skot/apw-meister/doc/apw-meister-bom.csv

Reference | Value | Footprint | Manufacturer | MPN | JLCPCB Part # | DNP | Assembly note
C10 | 0.1uF | aditBoard:C_0402_1005Metric | Samsung Electro-Mechanics | CL05B104KB54PNC | C307331
C17 | 1uF | aditBoard:C_0402_1005Metric | Samsung Electro-Mechanics | CL05A105KA5NQNC | C52923
C18 | 1uF | aditBoard:C_0402_1005Metric | Samsung Electro-Mechanics | CL05A105KA5NQNC | C52923
C19 | 100nF | aditBoard:C_0402_1005Metric | Samsung Electro-Mechanics | CL05B104KB54PNC | C307331
J1 | USB4105-GF-A-120 | aditBoard:USB_C_Receptacle_GCT_USB4105-xx-A_16P_TopMnt_Horizontal | Global Connector Technology | USB4105-GF-A-120 | C5184243
J2 | APW12 PSU Comm | aditBoard:CONN-TH_6P-P2.00_PHD-2X3A | HCTL | HC-PHD-2*3A | C2845614
Q1 | DMG1012T-7 | aditBoard:SOT-523 | Diodes Incorporated | DMG1012T-7 | C20512
Q2 | DMG1012T-7 | aditBoard:SOT-523 | Diodes Incorporated | DMG1012T-7 | C20512
Q3 | DMG1012T-7 | aditBoard:SOT-523 | Diodes Incorporated | DMG1012T-7 | C20512
R2 | 0 | aditBoard:R_0402_1005Metric | UNI-ROYAL(Uniroyal Elec) | 0402WGF0000TCE | C17168 |  | USB series tuning position; fit 0 ohm for WCH reference circuit.
R3 | 0 | aditBoard:R_0402_1005Metric | UNI-ROYAL(Uniroyal Elec) | 0402WGF0000TCE | C17168 |  | USB series tuning position; fit 0 ohm for WCH reference circuit.
R4 | 5.1k | aditBoard:R_0402_1005Metric | UNI-ROYAL(Uniroyal Elec) | 0402WGF5101TCE | C25905
R5 | 5.1k | aditBoard:R_0402_1005Metric | UNI-ROYAL(Uniroyal Elec) | 0402WGF5101TCE | C25905
R6 | 4.7k | aditBoard:R_0402_1005Metric | UNI-ROYAL(Uniroyal Elec) | 0402WGF4701TCE | C25900 |  | BOOT pull-up to 3.3 V through optional SW2.
R7 | 49.9k | aditBoard:R_0402_1005Metric | YAGEO | RC0402FR-0749K9L | C137969
R9 | 330 | aditBoard:R_0402_1005Metric | UNI-ROYAL(Uniroyal Elec) | 0402WGF3300TCE | C25104
R10 | 4.7k | aditBoard:R_0402_1005Metric | UNI-ROYAL(Uniroyal Elec) | 0402WGF4701TCE | C25900 |  | FIT: MCU-side 4.7k pull-up; APW side uses PSU pull-ups.
R11 | 4.7k | aditBoard:R_0402_1005Metric | UNI-ROYAL(Uniroyal Elec) | 0402WGF4701TCE | C25900 |  | FIT: MCU-side 4.7k pull-up; APW side uses PSU pull-ups.
R12 | 1k | aditBoard:R_0402_1005Metric | YAGEO | RC0402FR-071KL | C106235
R13 | 10k | aditBoard:R_0402_1005Metric | UNI-ROYAL(Uniroyal Elec) | 0402WGF1002TCE | C25744
SW2 | B3U-1000P | aditBoard:SW_SPST_B3U-1000P | Omron Electronics | B3U-1000P | C231329 | DNP | DNP: optional bottom-side development button.
SW3 | B3U-1000P | aditBoard:SW_SPST_B3U-1000P | Omron Electronics | B3U-1000P | C231329 | DNP | DNP: optional bottom-side development button.
TP1 | APW12_PIN1 | aditBoard:TestPoint_Pad_D1.0mm |  |  |  |  | Bare PCB copper test pad; no purchased component or JLCPCB part number.
TP2 | APW12_PIN4 | aditBoard:TestPoint_Pad_D1.0mm |  |  |  |  | Bare PCB copper test pad; no purchased component or JLCPCB part number.
U1 | SK6812SIDE-A-RVS | aditBoard:LED-SMD_4P-L4.0-W1.6-L | OPSCO Optoelectronics | SK6812SIDE-A-RVS | C2890037
U3 | CH32X035F8U6 | aditBoard:VQFN-20-1EP_3x3mm_P0.4mm_EP1.7x1.7mm | WCH (Jiangsu Qin Heng) | CH32X035F8U6 | C42442062 |  | QFN20 3x3 mm; exposed ground pad is pad 21 in this library.
U4 | AP2112K-3.3TRG1 | aditBoard:SOT-25-5_L2.9-W1.6-P0.95-LS2.8-BL | Diodes Incorporated | AP2112K-3.3TRG1 | C51118
U5 | TPD6E05U06RVZR | aditBoard:Texas_R-PUSON-N14 | Texas Instruments | TPD6E05U06RVZR | C962978
U6 | TPD4E05U06DQAR | aditBoard:USON-10_2.5x1.0mm_P0.5mm | Texas Instruments | TPD4E05U06DQAR | C138714
