skot/apw-meister/3d/kicad/Texas_R-PUSON-N14.step

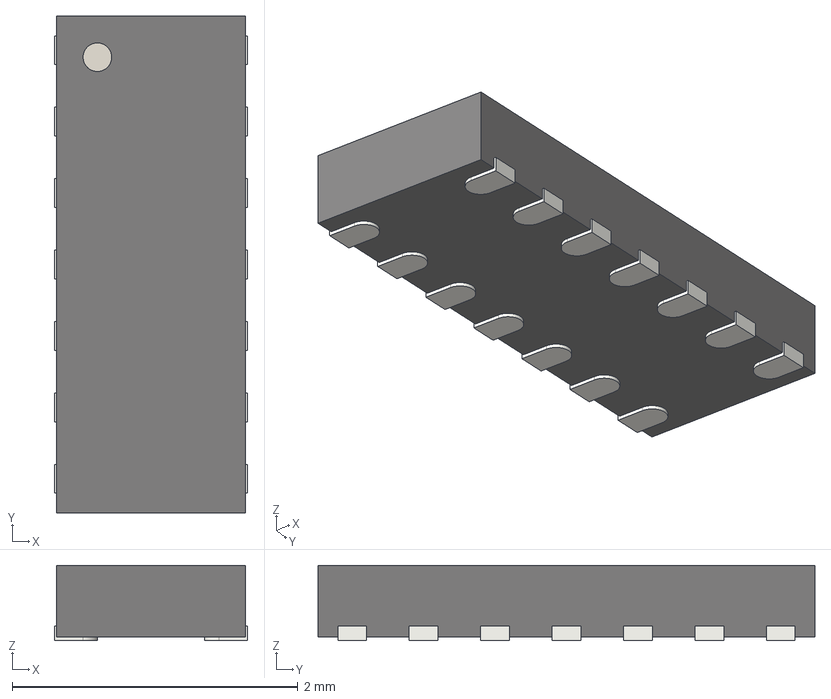
[picture p2: CAD file, 2026-10-26]
3d/kicad/Texas_R-PUSON-N14.step
1.35 x 3.48 x 0.525 mm
