skot/apw-meister/CAD/apw-meister.step

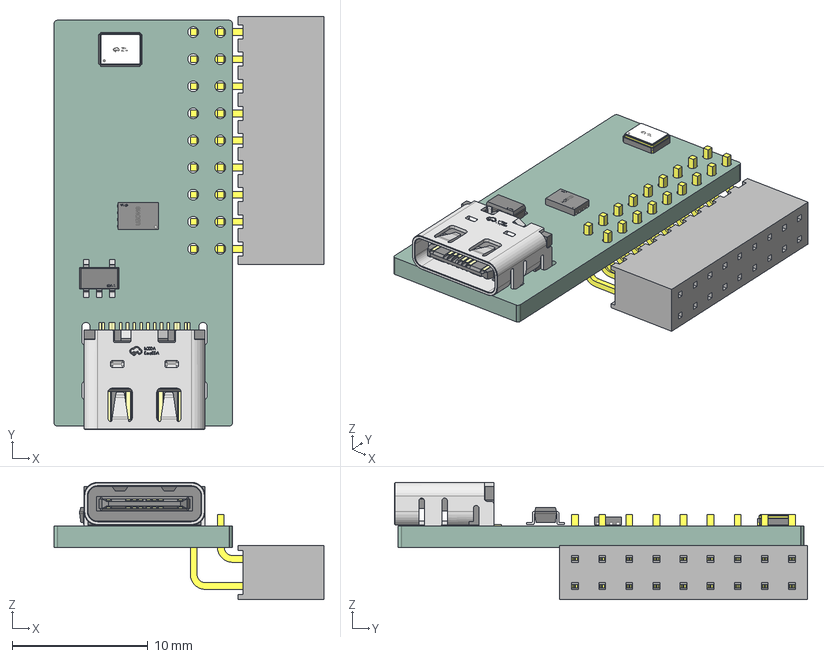
[picture p3: CAD file, 2026-10-22]
CAD/apw-meister.step
19.9 x 30.5 x 8.66 mm
SOT-25-5_L2.9-W1.6-P0.95-LS2.8-BL
USON-8_L3.0-W2.0-H0.6-P0.50
SQT-109-01-F-D-RA
OSC-SMD_4P-L3.2-W2.5-CJ13-320001210A20
USB-C-SMD_G-SWITCH_GT-USB-7010ASV
aditBoard_PCB
