skot/apw-meister/apw-meister.kicad_pcb

## KiCad design apw-meister.kicad_pcb (2026-10-27)

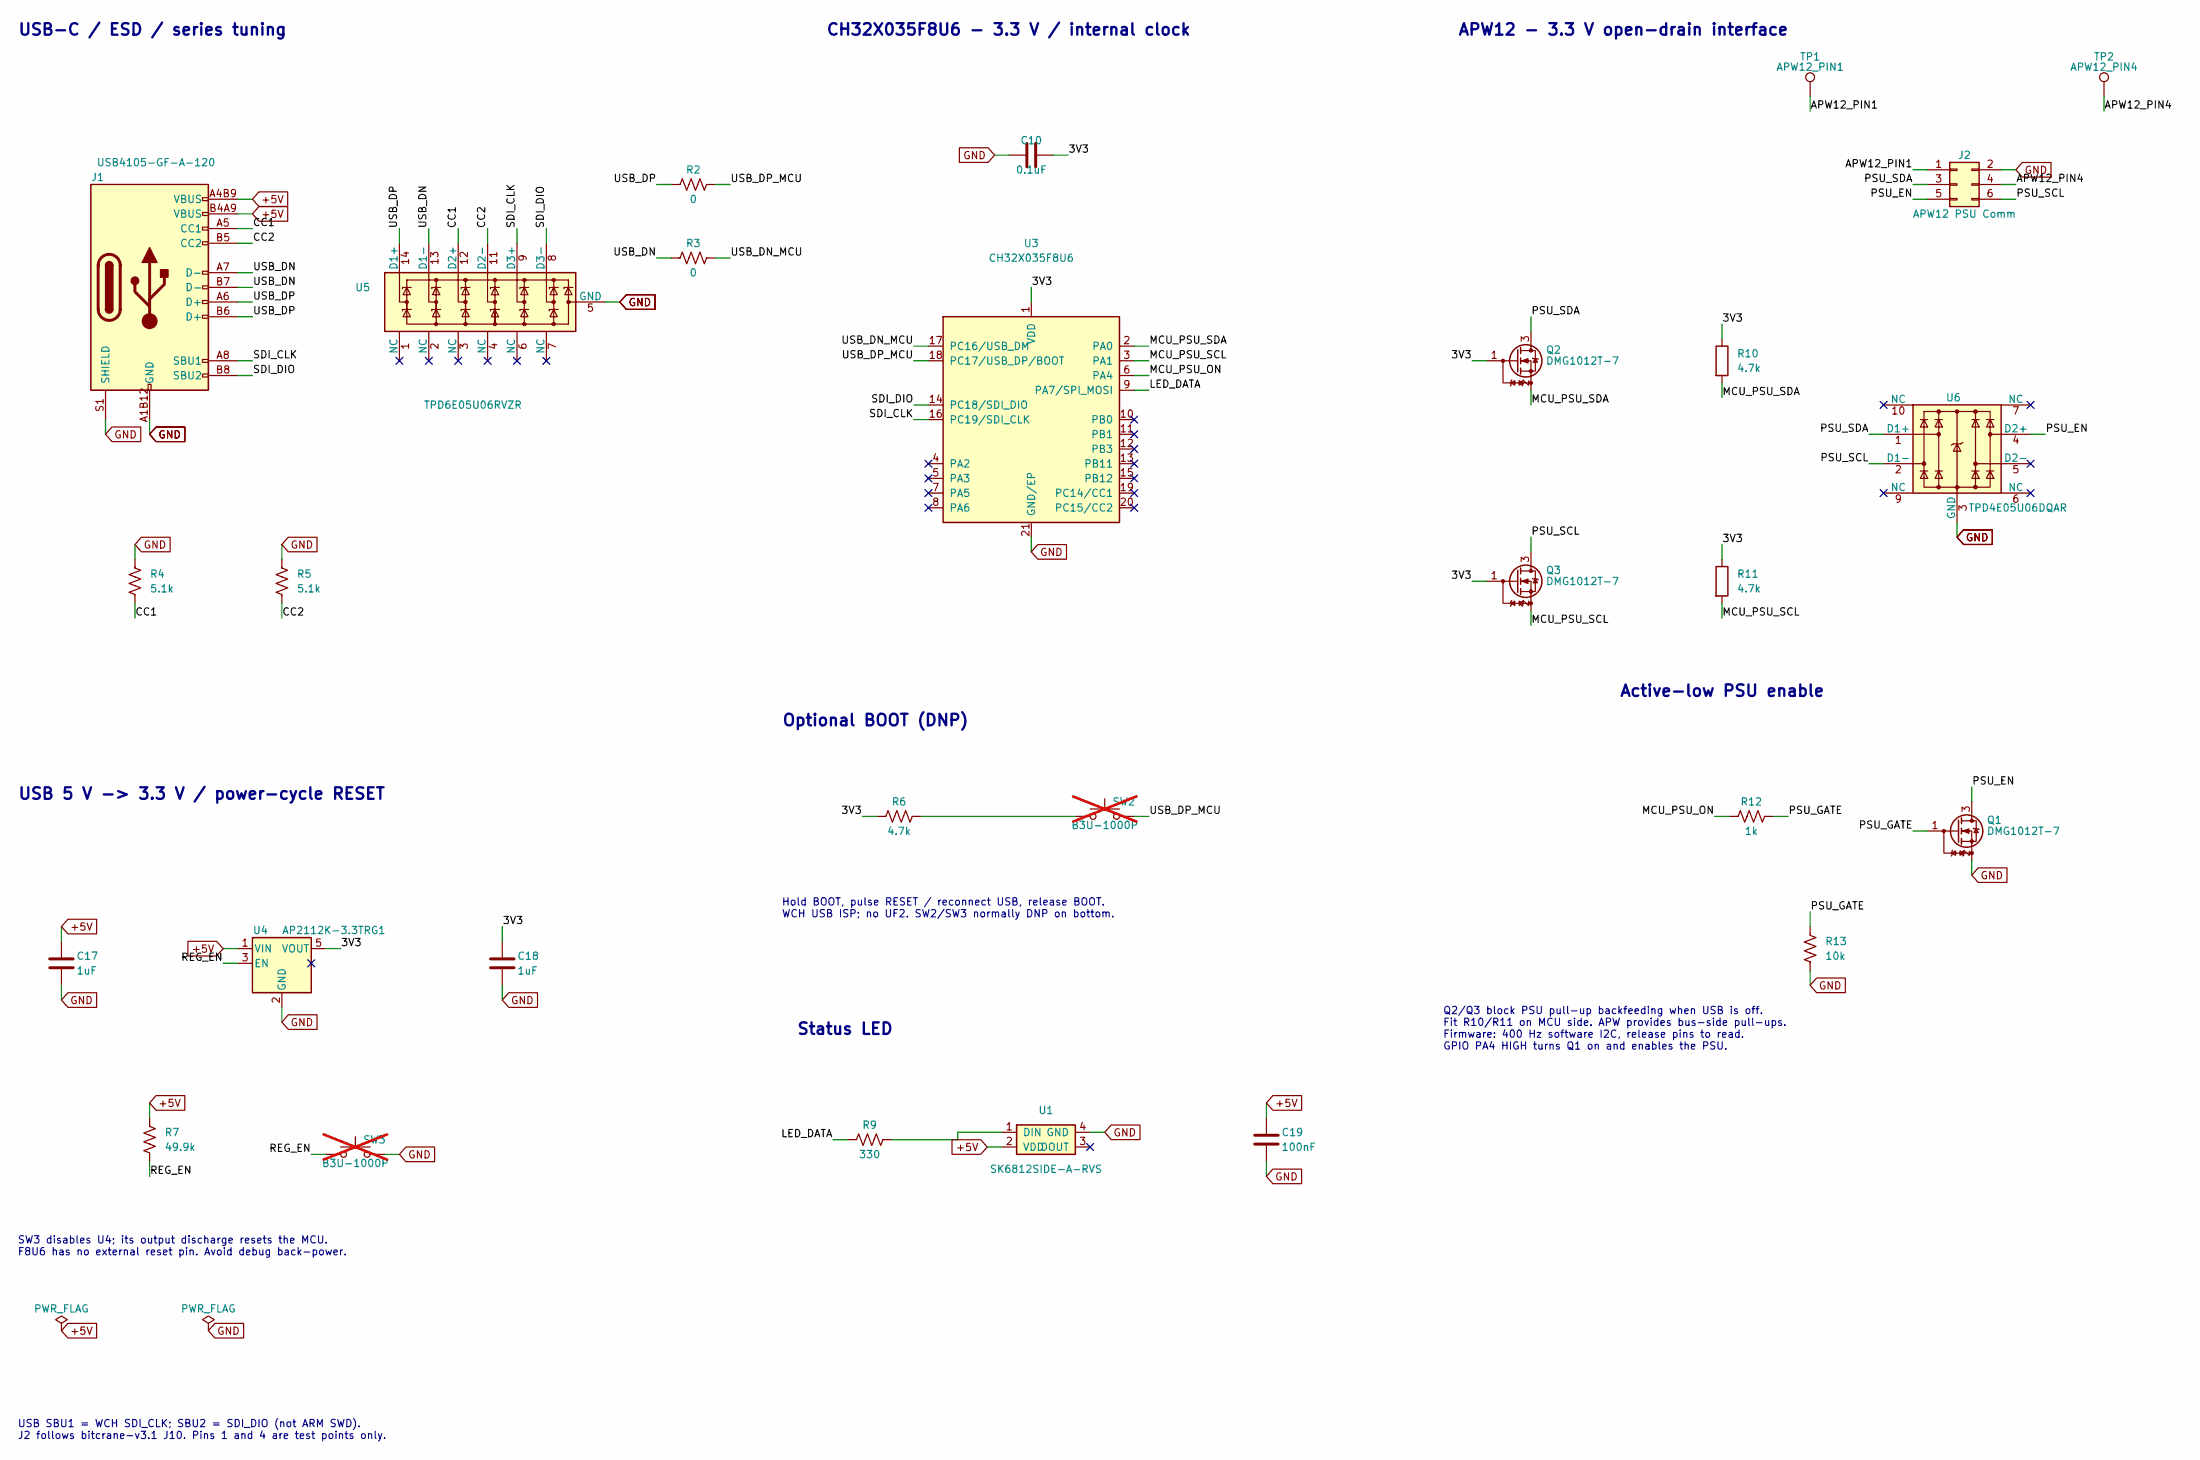
[picture p4: schematic apw-meister.kicad_sch, apw-meister - CH32X035F8U6]

Parts:
C10: 0.1uF; C_0402_1005Metric; Tolerance ±10%; Voltage 50V; MPN CL05B104KB54PNC; JLC Part Basic Part
C17, C18: 1uF; C_0402_1005Metric; Tolerance ±10%; Voltage 25V; MPN CL05A105KA5NQNC; JLC Part Basic Part
C19: 100nF; C_0402_1005Metric; Tolerance ±10%; Voltage 50V; MPN CL05B104KB54PNC; JLC Part Basic Part
J1: USB4105-GF-A-120; USB_C_Receptacle_GCT_USB4105-xx-A_16P_TopMnt_Horizontal; Voltage 48V; MPN USB4105-GF-A-120; JLC Part Extended Part
J2: APW12 PSU Comm; CONN-TH_6P-P2.00_PHD-2X3A; Voltage 250V; MPN HC-PHD-2*3A; JLC Part Extended Part
Q1, Q2, Q3: DMG1012T-7; SOT-523; MPN DMG1012T-7; JLC Part Extended Part
R2, R3: 0; R_0402_1005Metric; Tolerance ±1%; MPN 0402WGF0000TCE; JLC Part Basic Part
R4, R5: 5.1k; R_0402_1005Metric; Tolerance ±1%; MPN 0402WGF5101TCE; JLC Part Basic Part
R6, R10, R11: 4.7k; R_0402_1005Metric; Tolerance ±1%; MPN 0402WGF4701TCE; JLC Part Basic Part
R7: 49.9k; R_0402_1005Metric; Tolerance ±1%; MPN RC0402FR-0749K9L; JLC Part Extended Part
R9: 330; R_0402_1005Metric; Tolerance ±1%; MPN 0402WGF3300TCE; JLC Part Basic Part
R12: 1k; R_0402_1005Metric; Tolerance ±1%; MPN RC0402FR-071KL; JLC Part Extended Part
R13: 10k; R_0402_1005Metric; Tolerance ±1%; MPN 0402WGF1002TCE; JLC Part Basic Part
SW2, SW3: B3U-1000P; SW_SPST_B3U-1000P; Voltage 12V; MPN B3U-1000P; JLC Part Extended Part; not fitted
TP1: APW12_PIN1; TestPoint_Pad_D1.0mm
TP2: APW12_PIN4; TestPoint_Pad_D1.0mm
U1: SK6812SIDE-A-RVS; LED-SMD_4P-L4.0-W1.6-L; MPN SK6812SIDE-A-RVS; JLC Part Extended Part
U3: CH32X035F8U6; VQFN-20-1EP_3x3mm_P0.4mm_EP1.7x1.7mm; MPN CH32X035F8U6; JLC Part Extended Part
U4: AP2112K-3.3TRG1; SOT-25-5_L2.9-W1.6-P0.95-LS2.8-BL; MPN AP2112K-3.3TRG1; JLC Part Extended Part
U5: TPD6E05U06RVZR; Texas_R-PUSON-N14; MPN TPD6E05U06RVZR; JLC Part Extended Part
U6: TPD4E05U06DQAR; USON-10_2.5x1.0mm_P0.5mm; MPN TPD4E05U06DQAR; JLC Part Extended Part

Connections:
/3V3: C10.2, C18.1, Q2.1 (G), Q3.1 (G), R6.1, R10.1, R11.1, U3.1 (VDD), U4.5 (VOUT)
/APW12_PIN1: J2.1, TP1.1 (1_1)
/APW12_PIN4: J2.4, TP2.1 (1_1)
/CC1: J1.A5 (CC1), R4.2, U5.12 (D2+)
/CC2: J1.B5 (CC2), R5.2, U5.11 (D2-)
/LED_DATA: R9.1, U3.9 (PA7/SPI_MOSI)
/MCU_PSU_ON: R12.1, U3.6 (PA4)
/MCU_PSU_SCL: Q3.2 (S), R11.2, U3.3 (PA1)
/MCU_PSU_SDA: Q2.2 (S), R10.2, U3.2 (PA0)
/PSU_EN: J2.5, Q1.3 (D), U6.4 (D2+)
/PSU_GATE: Q1.1 (G), R12.2, R13.1
/PSU_SCL: J2.6, Q3.3 (D), U6.2 (D1-)
/PSU_SDA: J2.3, Q2.3 (D), U6.1 (D1+)
/REG_EN: R7.2, SW3.1, U4.3 (EN)
/SDI_CLK: J1.A8 (SBU1), U3.16 (PC19/SDI_CLK), U5.9 (D3+)
/SDI_DIO: J1.B8 (SBU2), U3.14 (PC18/SDI_DIO), U5.8 (D3-)
/USB_DN: J1.A7 (D-), J1.B7 (D-), R3.1, U5.13 (D1-)
/USB_DN_MCU: R3.2, U3.17 (PC16/USB_DM)
/USB_DP: J1.A6 (D+), J1.B6 (D+), R2.1, U5.14 (D1+)
/USB_DP_MCU: R2.2, SW2.2, U3.18 (PC17/USB_DP/BOOT)
unnamed: R6.2, SW2.1
unnamed: R9.2, U1.1 (DIN)

Notes on the sheet:
Hold BOOT, pulse RESET / reconnect USB, release BOOT. WCH USB ISP; no UF2. SW2/SW3 normally DNP on bottom.
SW3 disables U4; its output discharge resets the MCU. F8U6 has no external reset pin. Avoid debug back-power.
Q2/Q3 block PSU pull-up backfeeding when USB is off. Fit R10/R11 on MCU side. APW provides bus-side pull-ups. Firmware: 400 Hz software I2C, release pins to read. GPIO PA4 HIGH turns Q1 on and enables the PSU.
APW12 - 3.3 V open-drain interface
Status LED
USB 5 V -> 3.3 V / power-cycle RESET
USB SBU1 = WCH SDI_CLK; SBU2 = SDI_DIO (not ARM SWD). J2 follows bitcrane-v3.1 J10. Pins 1 and 4 are test points only.
CH32X035F8U6 - 3.3 V / internal clock
Optional BOOT (DNP)
Active-low PSU enable
USB-C / ESD / series tuning

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
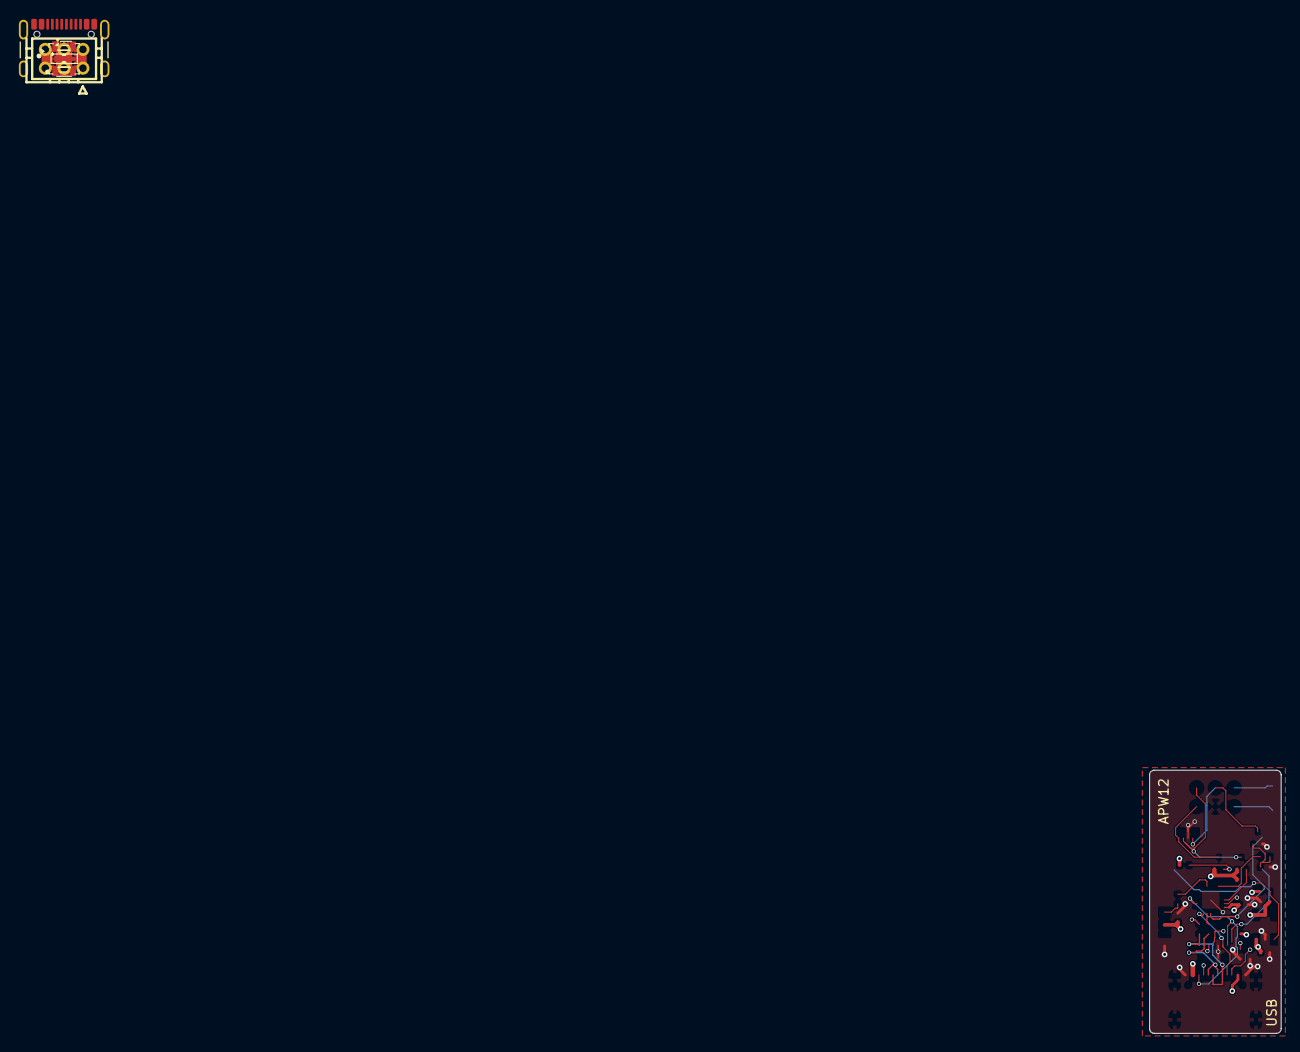
[picture p5: board apw-meister.kicad_pcb from above]

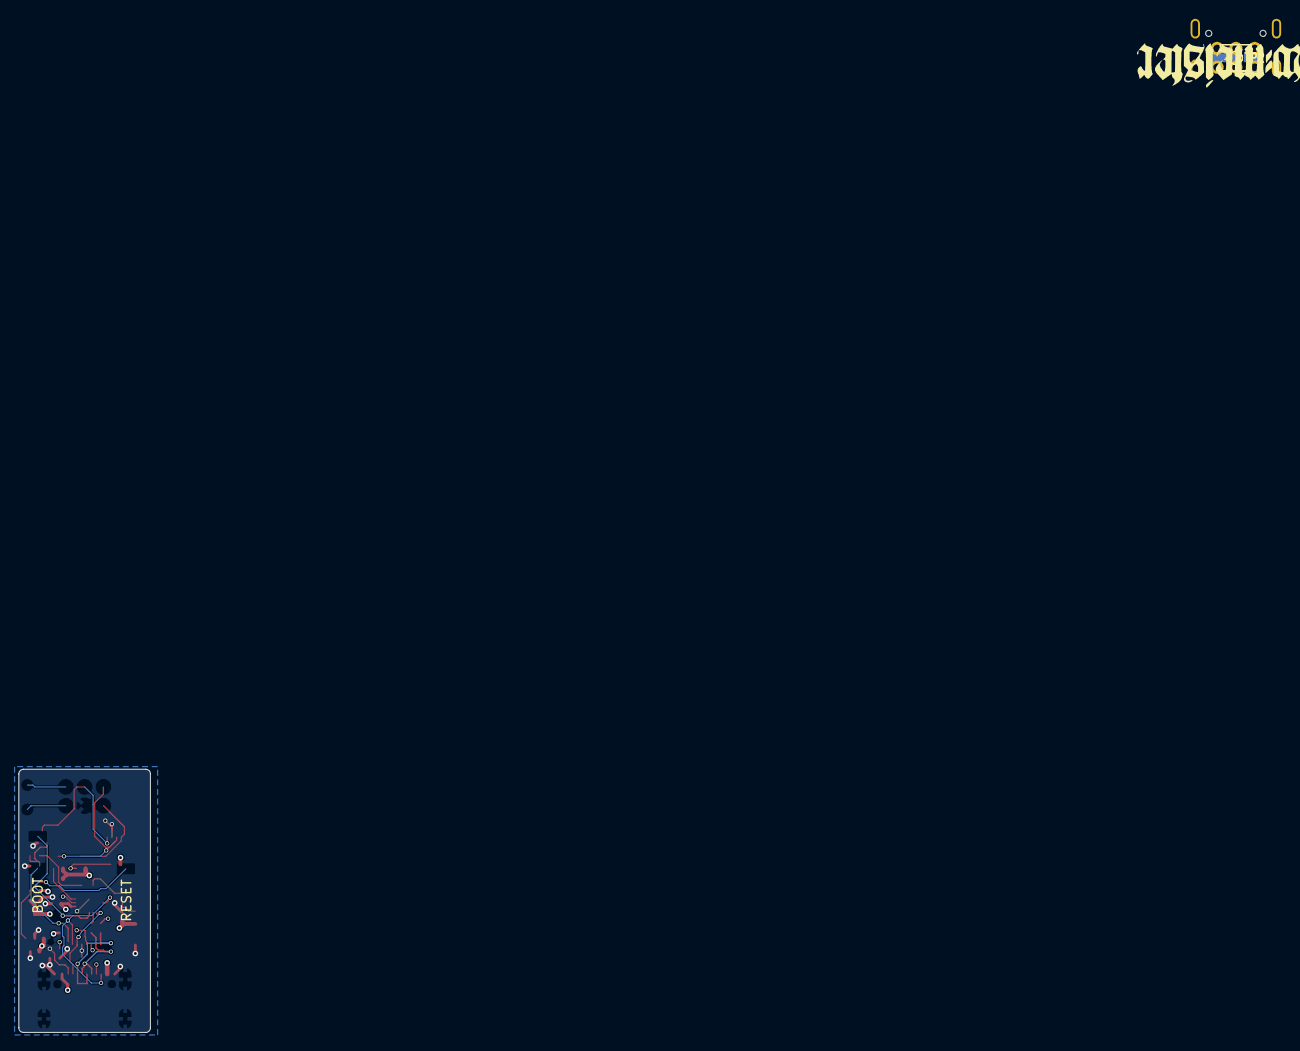
[picture p6: board apw-meister.kicad_pcb from below]

Board: 6 copper layers, 14.0 x 28.0 mm, 29 parts (4 on the bottom side), 24 nets.
