skot/apw-meister/(commit log)

2026-10-23 Configure the canonical top-level KiCad project
2026-10-26 Checkpoint RP2354A schematic, models, and initial PCB routing
2026-10-26 Import bonanzaDisplay track and via manufacturing limits
2026-10-27 Compact and route CH32 PCB with rear buttons and logo
2026-10-27 Show updated PCB render at top of README
